claudimir-lago/NAME/examples/README.md

# Example data

This directory contains real NAME acquisition data from capillary electrophoresis experiments.

File BAH112026.09.15_13h13m57s.dat has:

- time in min;
- first C4D (not present)
- second C4D in arbitrary unity
- measured current in uA
- charge in mC

These files provide a simple reference for independent implementations and for testing import into data-analysis software such as Zones.

Thanks to Pedro Volponi Conde
