claudimir-lago/NAME/docs/README.md

# Documentation

Technical documentation for NAME is being expanded progressively.

Available now:

- [`principle-of-operation.md`](principle-of-operation.md) — current-to-voltage conversion, differential zero adjustment, and calibration;
- [`project-status.md`](project-status.md) — implementation and validation status;
- [`interfacing.md`](interfacing.md) — connector pinout and minimal installation procedure;
- [`safety.md`](safety.md) — initial electrical-safety notes;
- [`zones-integration.md`](zones-integration.md) — relationship between NAME data acquisition and Zones.

Additional topics planned include assembly, testing, detailed validation, and expanded interfacing examples.
