claudimir-lago/NAME/images/README.md

# Images

This directory contains photographs, renderings, and diagrams for the NAME project.

- `NAME_assembled.jpeg` — photograph of an assembled NAME board already implemented in a working capillary electrophoresis instrument.

Additional photographs and diagrams may be added as the public documentation evolves.
