claudimir-lago/NAME/hardware/fabrication/BOM.csv

Id | Designador | Footprint | Quantidade | Designação | Fornecedor e referência
1 | C1, C3 | C_Disc_D4.7mm_W2.5mm_P5.00mm | 2 | 10n
2 | C2, C4, C5 | C_Disc_D4.7mm_W2.5mm_P5.00mm | 3 | 100n
3 | C6 | CP_Radial_D5.0mm_P2.00mm | 1 | 10µ
4 | J1 | TerminalBlock_MaiXu_MX126-5.0-02P_1x02_P5.00mm | 1 | return_HV
5 | J2 | Molex_KK-254_AE-6410-02A_1x02_P2.54mm_Vertical | 1 | Conn_01x02_Socket
6 | J3 | Molex_KK-254_AE-6410-06A_1x06_P2.54mm_Vertical | 1 | Conn_01x06_Socket
7 | L1 | L_Axial_L5.3mm_D2.2mm_P7.62mm_Horizontal_Vishay_IM-1 | 1 | 10u
8 | Q1, Q2 | TO-92L_Inline_Wide | 2 | J201
9 | R1 | R_Axial_DIN0207_L6.3mm_D2.5mm_P7.62mm_Horizontal | 1 | 1k
10 | R2, R3, R4, R5 | R_Axial_DIN0207_L6.3mm_D2.5mm_P7.62mm_Horizontal | 4 | 10k
11 | RV1 | Potentiometer_Bourns_3296W_Vertical | 1 | 1k
12 | U1 | ADS1220_module | 1 | ADS1220_Module
