claudimir-lago/NAME/images/schematic.pdf

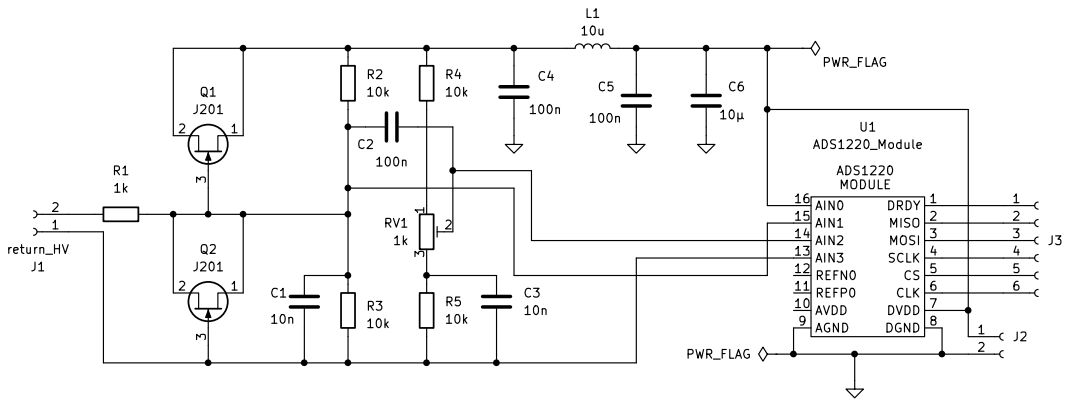
[picture p2: page 1]
