claudimir-lago/NAME/hardware/kicad/NAME.kicad_pcb

## KiCad design hardware/kicad/NAME.kicad_pcb (2026-10-14)

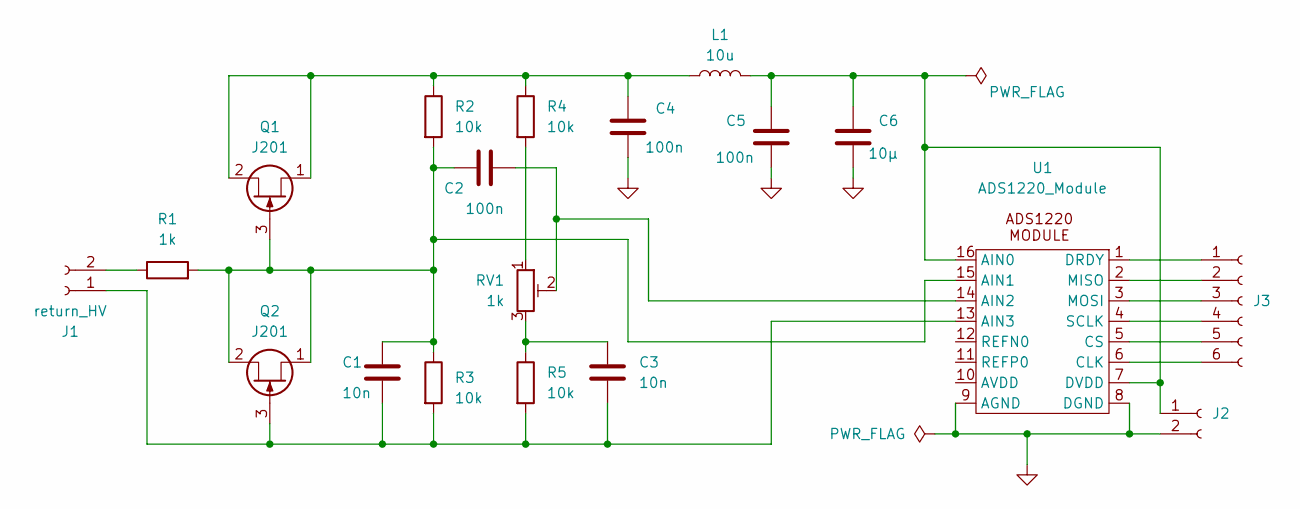
[picture p3: schematic NAME.kicad_sch, NanoAmpere Meter for Electrophoresis (NAME)]

Parts:
C1, C3: 10n; C_Disc_D4.7mm_W2.5mm_P5.00mm
C2, C4, C5: 100n; C_Disc_D4.7mm_W2.5mm_P5.00mm
C6: 10µ; CP_Radial_D5.0mm_P2.00mm
J1: return_HV; TerminalBlock_MaiXu_MX126-5.0-02P_1x02_P5.00mm
J2: Conn_01x02_Socket; Molex_KK-254_AE-6410-02A_1x02_P2.54mm_Vertical
J3: Conn_01x06_Socket; Molex_KK-254_AE-6410-06A_1x06_P2.54mm_Vertical
L1: 10u; L_Axial_L5.3mm_D2.2mm_P7.62mm_Horizontal_Vishay_IM-1
Q1, Q2: J201; TO-92L_Inline_Wide
R1: 1k; R_Axial_DIN0207_L6.3mm_D2.5mm_P7.62mm_Horizontal
R2, R3, R4, R5: 10k; R_Axial_DIN0207_L6.3mm_D2.5mm_P7.62mm_Horizontal
RV1: 1k; Potentiometer_Bourns_3296W_Vertical
U1: ADS1220_Module; ADS1220_module

Connections:
GNDA: C4.2, C5.2, C6.2, J2.2, U1.8 (DGND), U1.9 (AGND)
unnamed: C3.1, R5.1, RV1.3
unnamed: C1.2, C3.2, J1.1, Q2.3 (G), R3.2, R5.2, U1.13 (AIN3)
unnamed: J1.2, R1.1
unnamed: C5.1, C6.1, J2.1, L1.2, U1.7 (DVDD), U1.16 (AIN0)
unnamed: J3.1, U1.1 (DRDY)
unnamed: J3.2, U1.2 (MISO)
unnamed: J3.3, U1.3 (MOSI)
unnamed: J3.4, U1.4 (SCLK)
unnamed: J3.5, U1.5 (CS)
unnamed: J3.6, U1.6 (CLK)
unnamed: C4.1, L1.1, Q1.1 (S), Q1.2 (D), R2.1, R4.1
unnamed: C1.1, C2.2, Q1.3 (G), Q2.1 (S), Q2.2 (D), R1.2, R2.2, R3.1, U1.15 (AIN1)
unnamed: R4.2, RV1.1
unnamed: C2.1, RV1.2, U1.14 (AIN2)

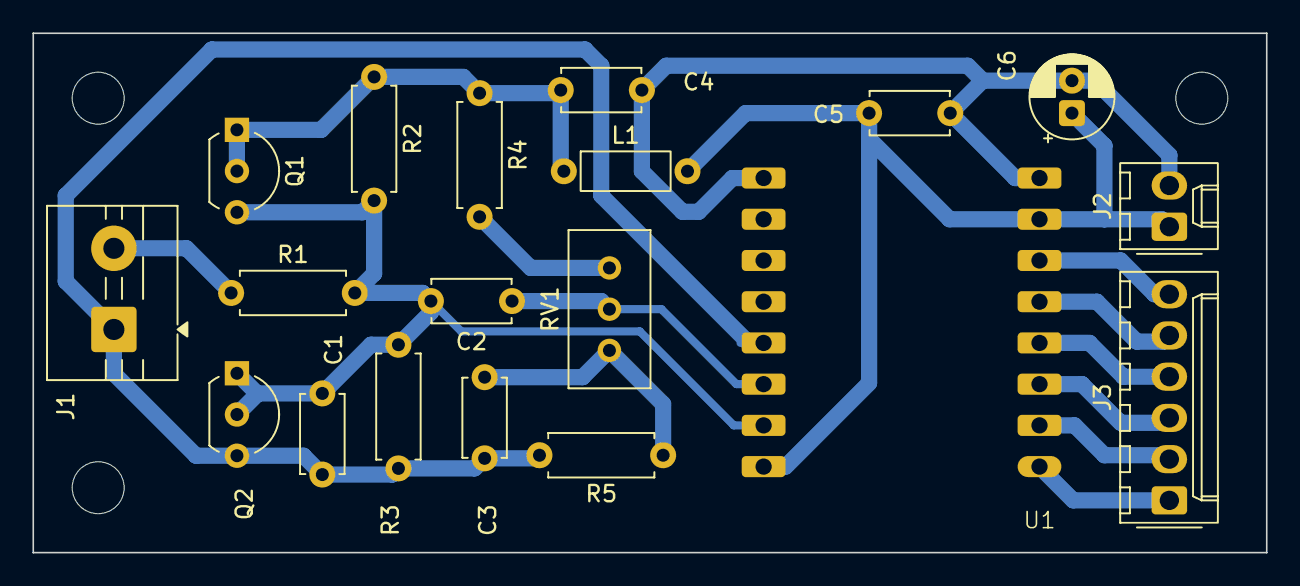
[picture p4: board NAME.kicad_pcb from above]

Board: 2 copper layers, 76.0 x 32.0 mm, 19 parts (0 on the bottom side), 15 nets.
